dsperlich/DAC-ADC-PiHat/DAC-ADC-PiHat.kicad_pcb

## KiCad design DAC-ADC-PiHat.kicad_pcb (2022-10-30)

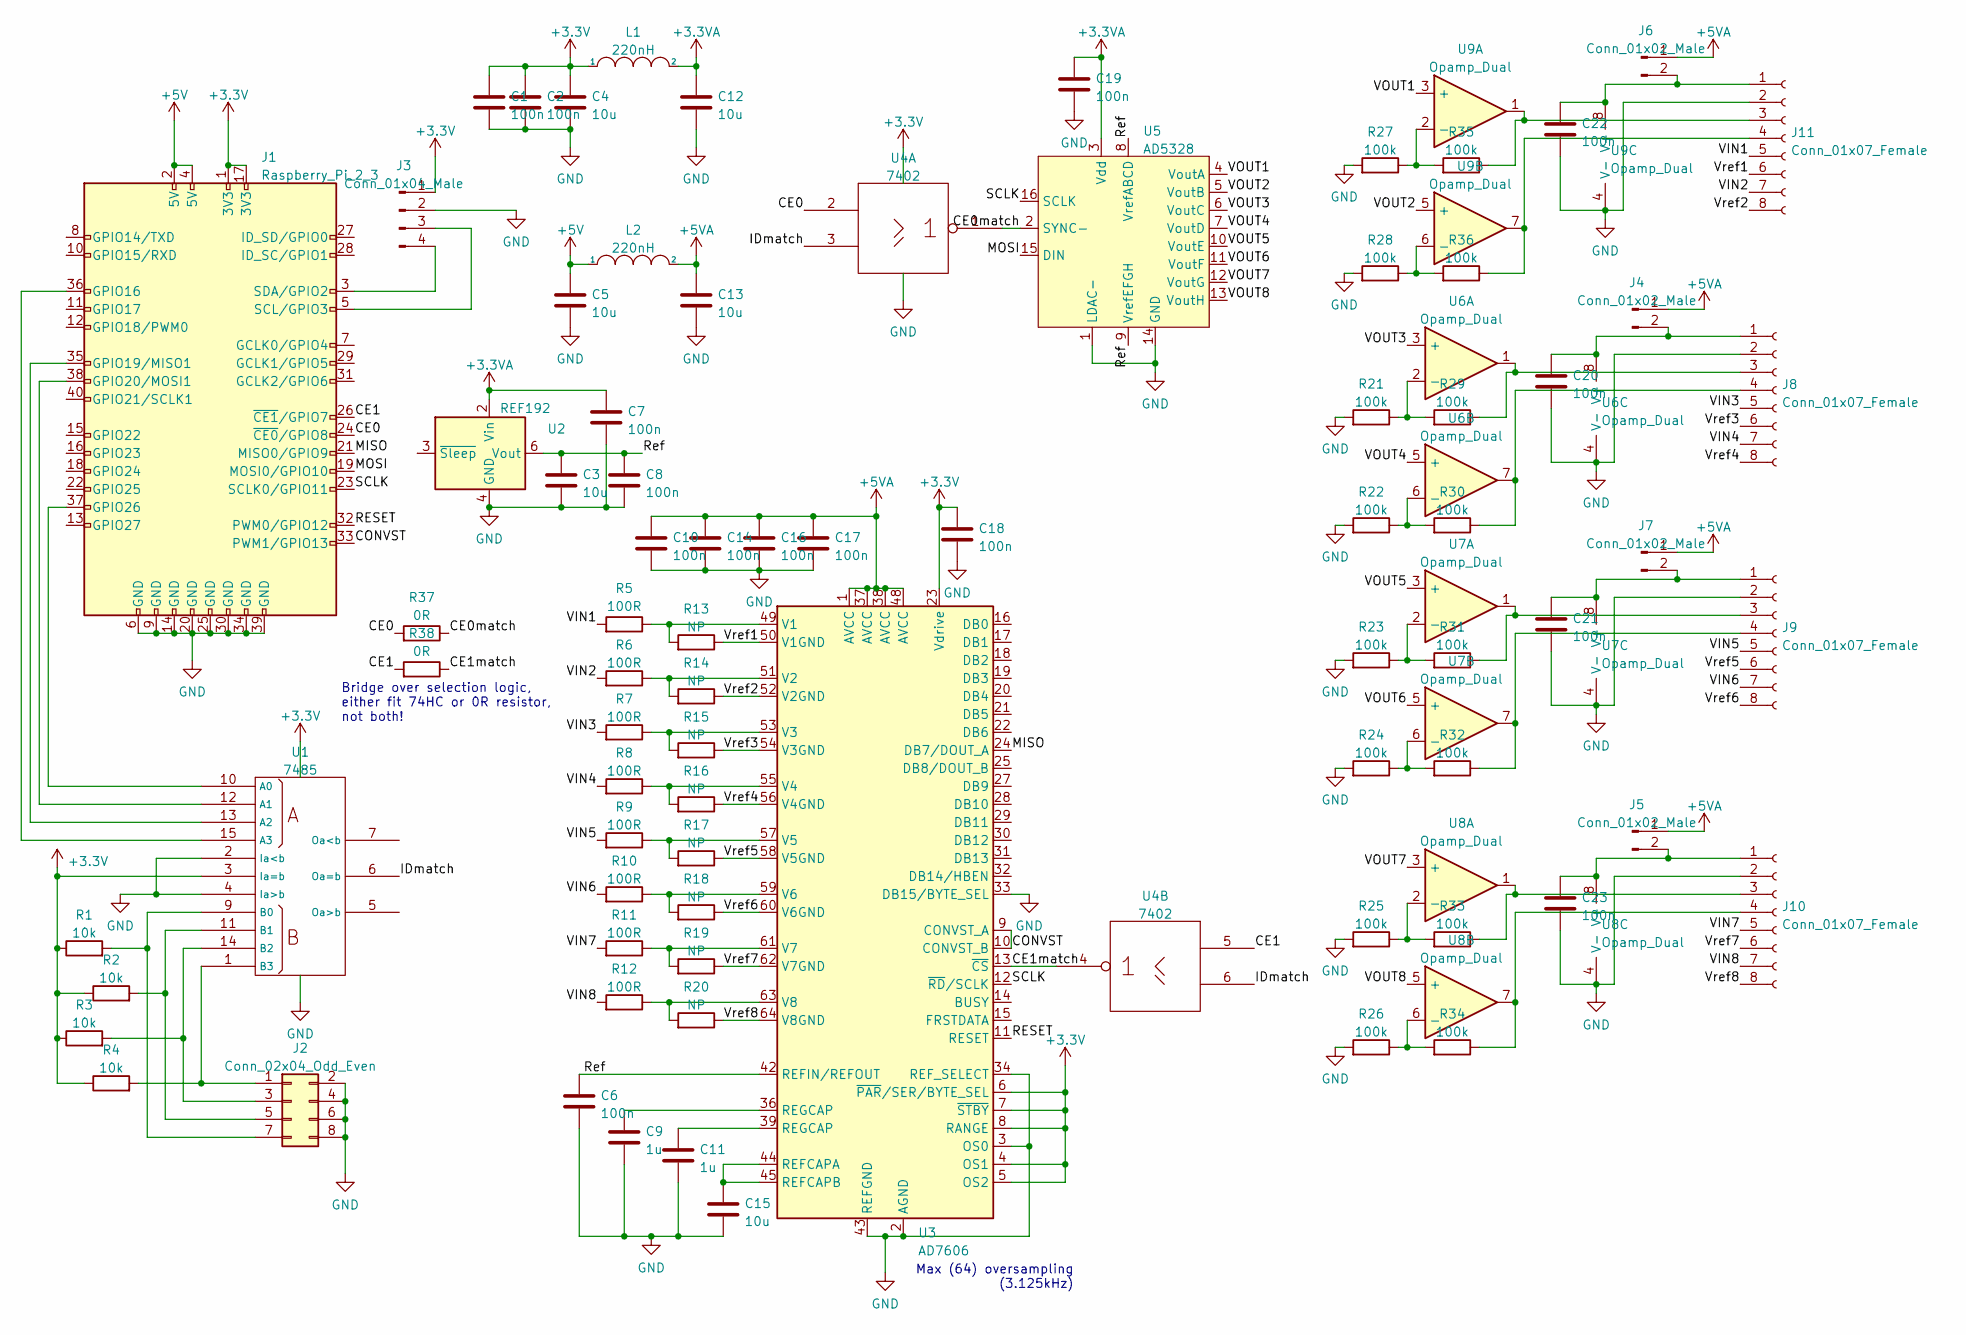
[picture p1: schematic DAC-ADC-PiHat.kicad_sch]

Parts:
C1, C2, C6, C7, C8, C10, C14, C16, C17, C18, C19, C20, C21, C22, C23: 100n; C_0402_1005Metric
C3, C4, C5, C12, C13, C15: 10u; C_0603_1608Metric
C9, C11: 1u; C_0603_1608Metric
J1: Raspberry_Pi_2_3; PinSocket_2x20_P2.54mm_Vertical
J2: Conn_02x04_Odd_Even; PinHeader_2x04_P2.54mm_Vertical
J3: Conn_01x04_Male; PinHeader_1x04_P2.54mm_Vertical
J4, J5, J6, J7: Conn_01x02_Male; PinHeader_1x02_P2.54mm_Vertical
J8, J9, J10, J11: Conn_01x07_Female; PinSocket_1x08_P2.54mm_Horizontal
L1, L2: 220nH; L_1210_3225Metric
R1, R2, R3, R4: 10k; R_0603_1608Metric
R5, R6, R7, R8, R9, R10, R11, R12: 100R; R_0603_1608Metric
R13, R14, R15, R16, R17, R18, R19, R20: NP; R_0603_1608Metric
R21, R22, R23, R24, R25, R26, R27, R28, R29, R30, R31, R32, R33, R34, R35, R36: 100k; R_0603_1608Metric
R37, R38: 0R; R_0603_1608Metric
U1: 7485; SOIC-16_3.9x9.9mm_P1.27mm
U2: REF192; SOIC-8_3.9x4.9mm_P1.27mm
U3: AD7606; LQFP-64_10x10mm_P0.5mm
U4: 7402; SOIC-14_3.9x8.7mm_P1.27mm
U5: AD5328; TSSOP-16-1EP_4.4x5mm_P0.65mm
U6, U7, U8, U9: Opamp_Dual; SOP-8_3.9x4.9mm_P1.27mm

Connections:
+3.3V: C1.1, C2.1, C4.1, C18.1, J1.1 (3V3), J1.17 (3V3), J3.1, L1.1, R1.1, R2.1, R3.1, R4.1, U1.3 (Ia=b), U1.16 (VCC), U3.4 (OS1), U3.5 (OS2), U3.6 (~PAR/SER/BYTE_SEL), U3.7 (~STBY), U3.8 (RANGE), U3.23 (Vdrive), U4.14 (VCC)
+3.3VA: C7.1, C12.1, C19.1, L1.2, U2.2 (Vin), U5.3 (Vdd)
+5V: C5.1, J1.2 (5V), J1.4 (5V), L2.1
+5VA: C10.1, C13.1, C14.1, C16.1, C17.1, J4.1, J5.1, J6.1, J7.1, L2.2, U3.1 (AVCC), U3.37 (AVCC), U3.38 (AVCC), U3.48 (AVCC)
/CE0: J1.24 (~CE0/GPIO8), R37.2, U4.2
/CE0match: R37.1, U4.1, U5.2 (SYNC-)
/CE1: J1.26 (~CE1/GPIO7), R38.2, U4.5
/CE1match: R38.1, U3.13 (~CS), U4.4
/CONVST: J1.33 (PWM1/GPIO13), U3.9 (CONVST_A), U3.10 (CONVST_B)
/IDmatch: U1.6 (Oa=b), U4.3, U4.6
/MISO: J1.21 (MISO0/GPIO9), U3.24 (DB7/DOUT_A)
/MOSI: J1.19 (MOSI0/GPIO10), U5.15 (DIN)
/RESET: J1.32 (PWM0/GPIO12), U3.11 (RESET)
/Ref: C3.1, C6.1, C8.1, U2.6 (Vout), U3.42 (REFIN/REFOUT), U5.8 (VrefABCD), U5.9 (VrefEFGH)
/SCLK: J1.23 (SCLK0/GPIO11), U3.12 (~RD/SCLK), U5.16 (SCLK)
/VIN1: J11.5, R5.2
/VIN2: J11.7, R6.2
/VIN3: J8.5, R7.2
/VIN4: J8.7, R8.2
/VIN5: J9.5, R9.2
/VIN6: J9.7, R10.2
/VIN7: J10.5, R11.2
/VIN8: J10.7, R12.2
/VOUT1: U5.4 (VoutA), U9.3 (+)
/VOUT2: U5.5 (VoutB), U9.5 (+)
/VOUT3: U5.6 (VoutC), U6.3 (+)
/VOUT4: U5.7 (VoutD), U6.5 (+)
/VOUT5: U5.10 (VoutE), U7.3 (+)
/VOUT6: U5.11 (VoutF), U7.5 (+)
/VOUT7: U5.12 (VoutG), U8.3 (+)
/VOUT8: U5.13 (VoutH), U8.5 (+)
/Vref1: J11.6, R13.1, U3.50 (V1GND)
/Vref2: J11.8, R14.1, U3.52 (V2GND)
/Vref3: J8.6, R15.1, U3.54 (V3GND)
/Vref4: J8.8, R16.1, U3.56 (V4GND)
/Vref5: J9.6, R17.1, U3.58 (V5GND)
/Vref6: J9.8, R18.1, U3.60 (V6GND)
/Vref7: J10.6, R19.1, U3.62 (V7GND)
/Vref8: J10.8, R20.1, U3.64 (V8GND)
GND: C1.2, C2.2, C3.2, C4.2, C5.2, C6.2, C7.2, C8.2, C9.2, C10.2, C11.2, C12.2, C13.2, C14.2, C15.2, C16.2, C17.2, C18.2, C19.2, C20.2, C21.2, C22.2, C23.2, J1.6 (GND), J1.9 (GND), J1.14 (GND), J1.20 (GND), J1.25 (GND), J1.30 (GND), J1.34 (GND), J1.39 (GND), J2.2, J2.4, J2.6, J2.8, J3.2, J8.2, J9.2, J10.2, J11.2, R21.2, R22.2, R23.2, R24.2, R25.2, R26.2, R27.2, R28.2, U1.2 (Ia<b), U1.4 (Ia>b), U1.8 (GND), U2.4 (GND), U3.2 (AGND), U3.3 (OS0), U3.26 (AGND), U3.33 (DB15/BYTE_SEL), U3.34 (REF_SELECT), U3.35 (AGND), U3.40 (AGND), U3.41 (AGND), U3.43 (REFGND), U3.46 (REFGND), U3.47 (AGND), U4.7 (GND), U5.1 (LDAC-), U5.14 (GND), U6.4 (V-), U7.4 (V-), U8.4 (V-), U9.4 (V-)
unnamed: C9.1, U3.36 (REGCAP)
unnamed: C11.1, U3.39 (REGCAP)
unnamed: C15.1, U3.44 (REFCAPA), U3.45 (REFCAPB)
unnamed: C22.1, J6.2, J11.1, U9.8 (V+)
unnamed: C23.1, J5.2, J10.1, U8.8 (V+)
unnamed: J1.3 (SDA/GPIO2), J3.4
unnamed: J1.5 (SCL/GPIO3), J3.3
unnamed: J1.35 (GPIO19/MISO1), U1.13 (A2)
unnamed: J1.36 (GPIO16), U1.15 (A3)
unnamed: J1.37 (GPIO26), U1.10 (A0)
unnamed: J2.1, R4.2, U1.1 (B3)
unnamed: J2.3, R3.2, U1.14 (B2)
unnamed: J2.5, R2.2, U1.11 (B1)
unnamed: J2.7, R1.2, U1.9 (B0)
unnamed: C20.1, J4.2, J8.1, U6.8 (V+)
unnamed: C21.1, J7.2, J9.1, U7.8 (V+)
unnamed: J8.3, R29.1, U6.1
unnamed: J8.4, R30.1, U6.7
unnamed: J9.3, R31.1, U7.1
unnamed: J9.4, R32.1, U7.7
unnamed: J10.3, R33.1, U8.1
unnamed: J10.4, R34.1, U8.7
unnamed: J11.3, R35.1, U9.1
unnamed: J11.4, R36.1, U9.7
unnamed: R10.1, R18.2, U3.59 (V6)
unnamed: R11.1, R19.2, U3.61 (V7)
unnamed: R12.1, R20.2, U3.63 (V8)
unnamed: R5.1, R13.2, U3.49 (V1)
unnamed: R6.1, R14.2, U3.51 (V2)
unnamed: R7.1, R15.2, U3.53 (V3)
unnamed: R8.1, R16.2, U3.55 (V4)
unnamed: R9.1, R17.2, U3.57 (V5)
unnamed: R21.1, R29.2, U6.2 (-)
unnamed: R22.1, R30.2, U6.6 (-)
unnamed: R23.1, R31.2, U7.2 (-)
unnamed: R24.1, R32.2, U7.6 (-)
unnamed: R25.1, R33.2, U8.2 (-)
unnamed: R26.1, R34.2, U8.6 (-)
unnamed: R27.1, R35.2, U9.2 (-)
unnamed: R28.1, R36.2, U9.6 (-)
unnamed: J1.38 (GPIO20/MOSI1), U1.12 (A1)

Notes on the sheet:
Max (64) oversampling (3.125kHz)
Bridge over selection logic, either fit 74HC or 0R resistor, not both!

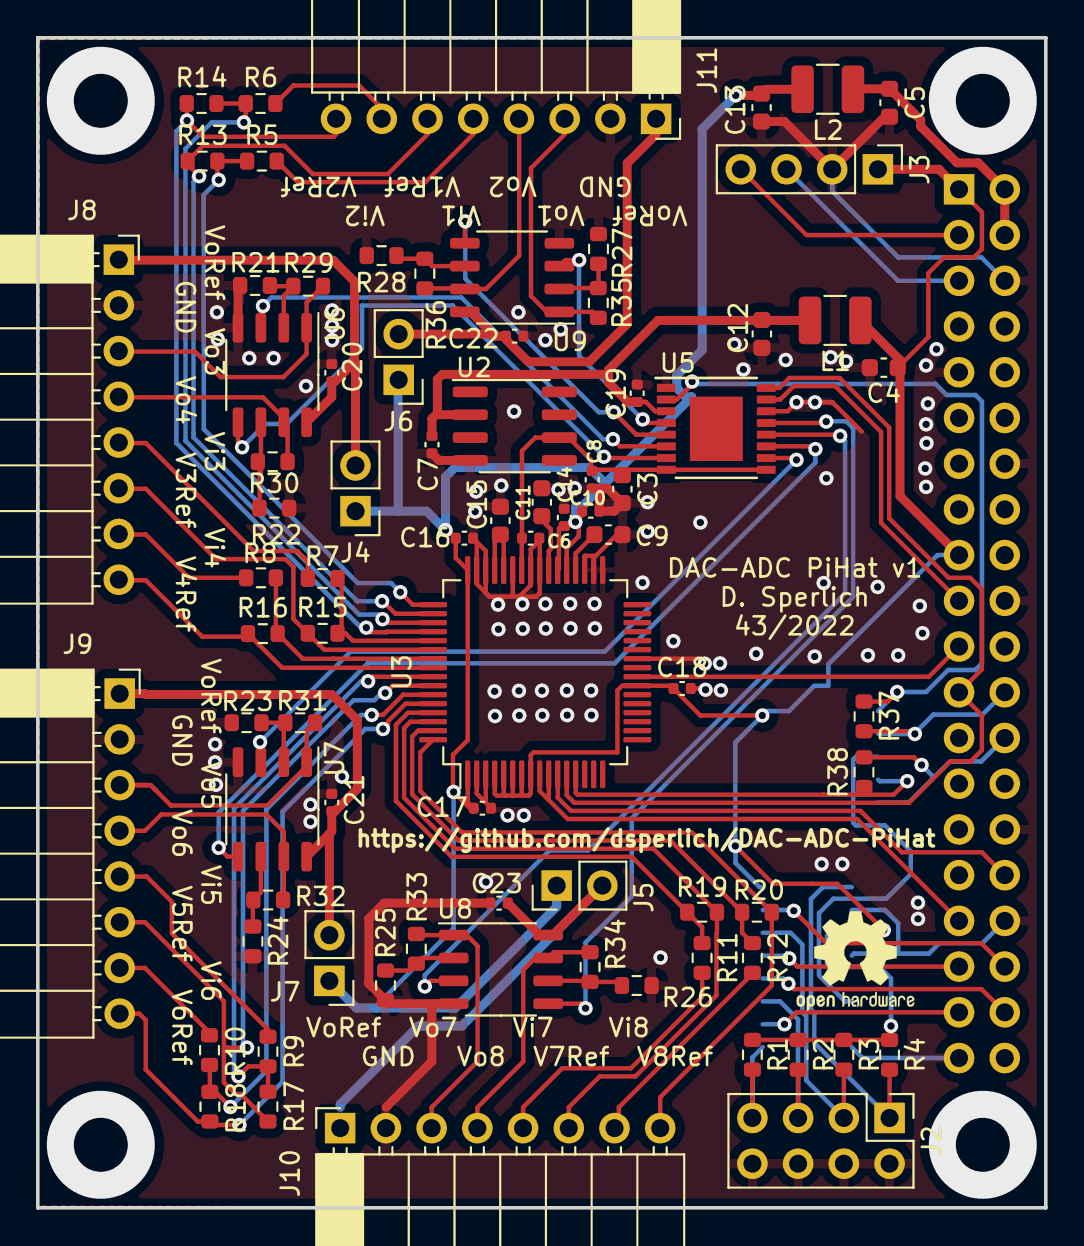
[picture p2: board DAC-ADC-PiHat.kicad_pcb from above]

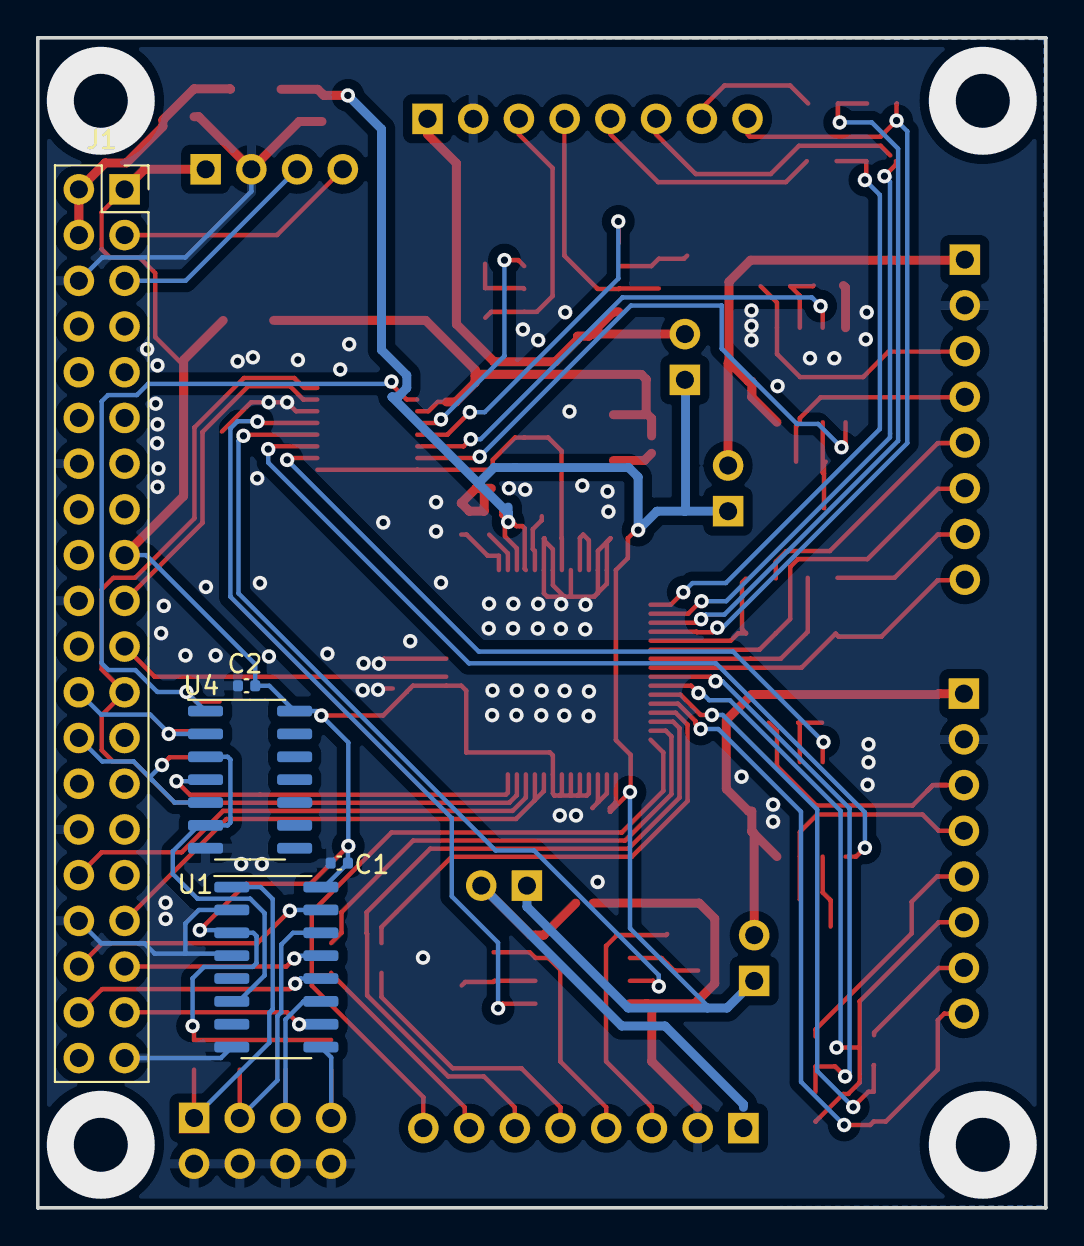
[picture p3: board DAC-ADC-PiHat.kicad_pcb from below]

Board: 2 copper layers, 56.0 x 65.0 mm, 83 parts (5 on the bottom side), 81 nets.
